PeteWasEre/Very-Kerbal-Kontroller-V2/Documentation/KSP Controller Design Data.xlsx

Sheet: Pin Map
DIO | MODE | Connection | Notes | AIO | Mode | Connection | Notes | MUX | 0 | 1 | 2 | 3 | 4 |  |  |  | Input | Output
0 | NC | NC | Mirrors USB serial | A0 | INPUT | Temp sense |  | A0 | SAS2 | FC Sensitivity |  | RCS | Throttle R |  |  | 0 | -1 | -1
1 | NC | NC | Mirrors USB serial | A1 | INPUT | Translation X |  | A1 | SAS3 | Stage |  | Lights | Throttle G |  |  | 1 | -0.9921568627 | -0.9901960784
2 | INP_PULLUP | Tr Pitch Up |  | A2 | INPUT | Translation Y |  | A2 | SAS4 | Brakes |  | Gear B | Throttle B |  |  | 2 | -0.9843137255 | -0.9803921569
3 | INP_PULLUP | Tr Pitch DN |  | A3 | INPUT | Translation Z |  | A3 | SAS5 | CLR TGT | AG 6 | Gear G | Controls R |  |  | 3 | -0.9764705882 | -0.9705882353
4 | INP_PULLUP | Tr Yaw R |  | A4 | INPUT | Rotation X |  | A4 | SAS6 | LG OFF | AG 7 | NWS | Controls G |  |  | 4 | -0.968627451 | -0.9607843137
5 | INP_PULLUP | Tr Yaw L |  | A5 | INPUT | Rotation Y |  | A5 | SAS7 | LG HI | AG 8 | Brakes G | Controls B |  |  | 5 | -0.9607843137 | -0.9509803922
6 |  |  |  | A6 | INPUT | Rotation Z |  | A6 | SAS8 | Lights | AG 9 | Brakes B | SAS R |  |  | 6 | -0.9529411765 | -0.9411764706
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
