PeteWasEre/Very-Kerbal-Kontroller-V2/Documentation/Panel Schematics.pdf

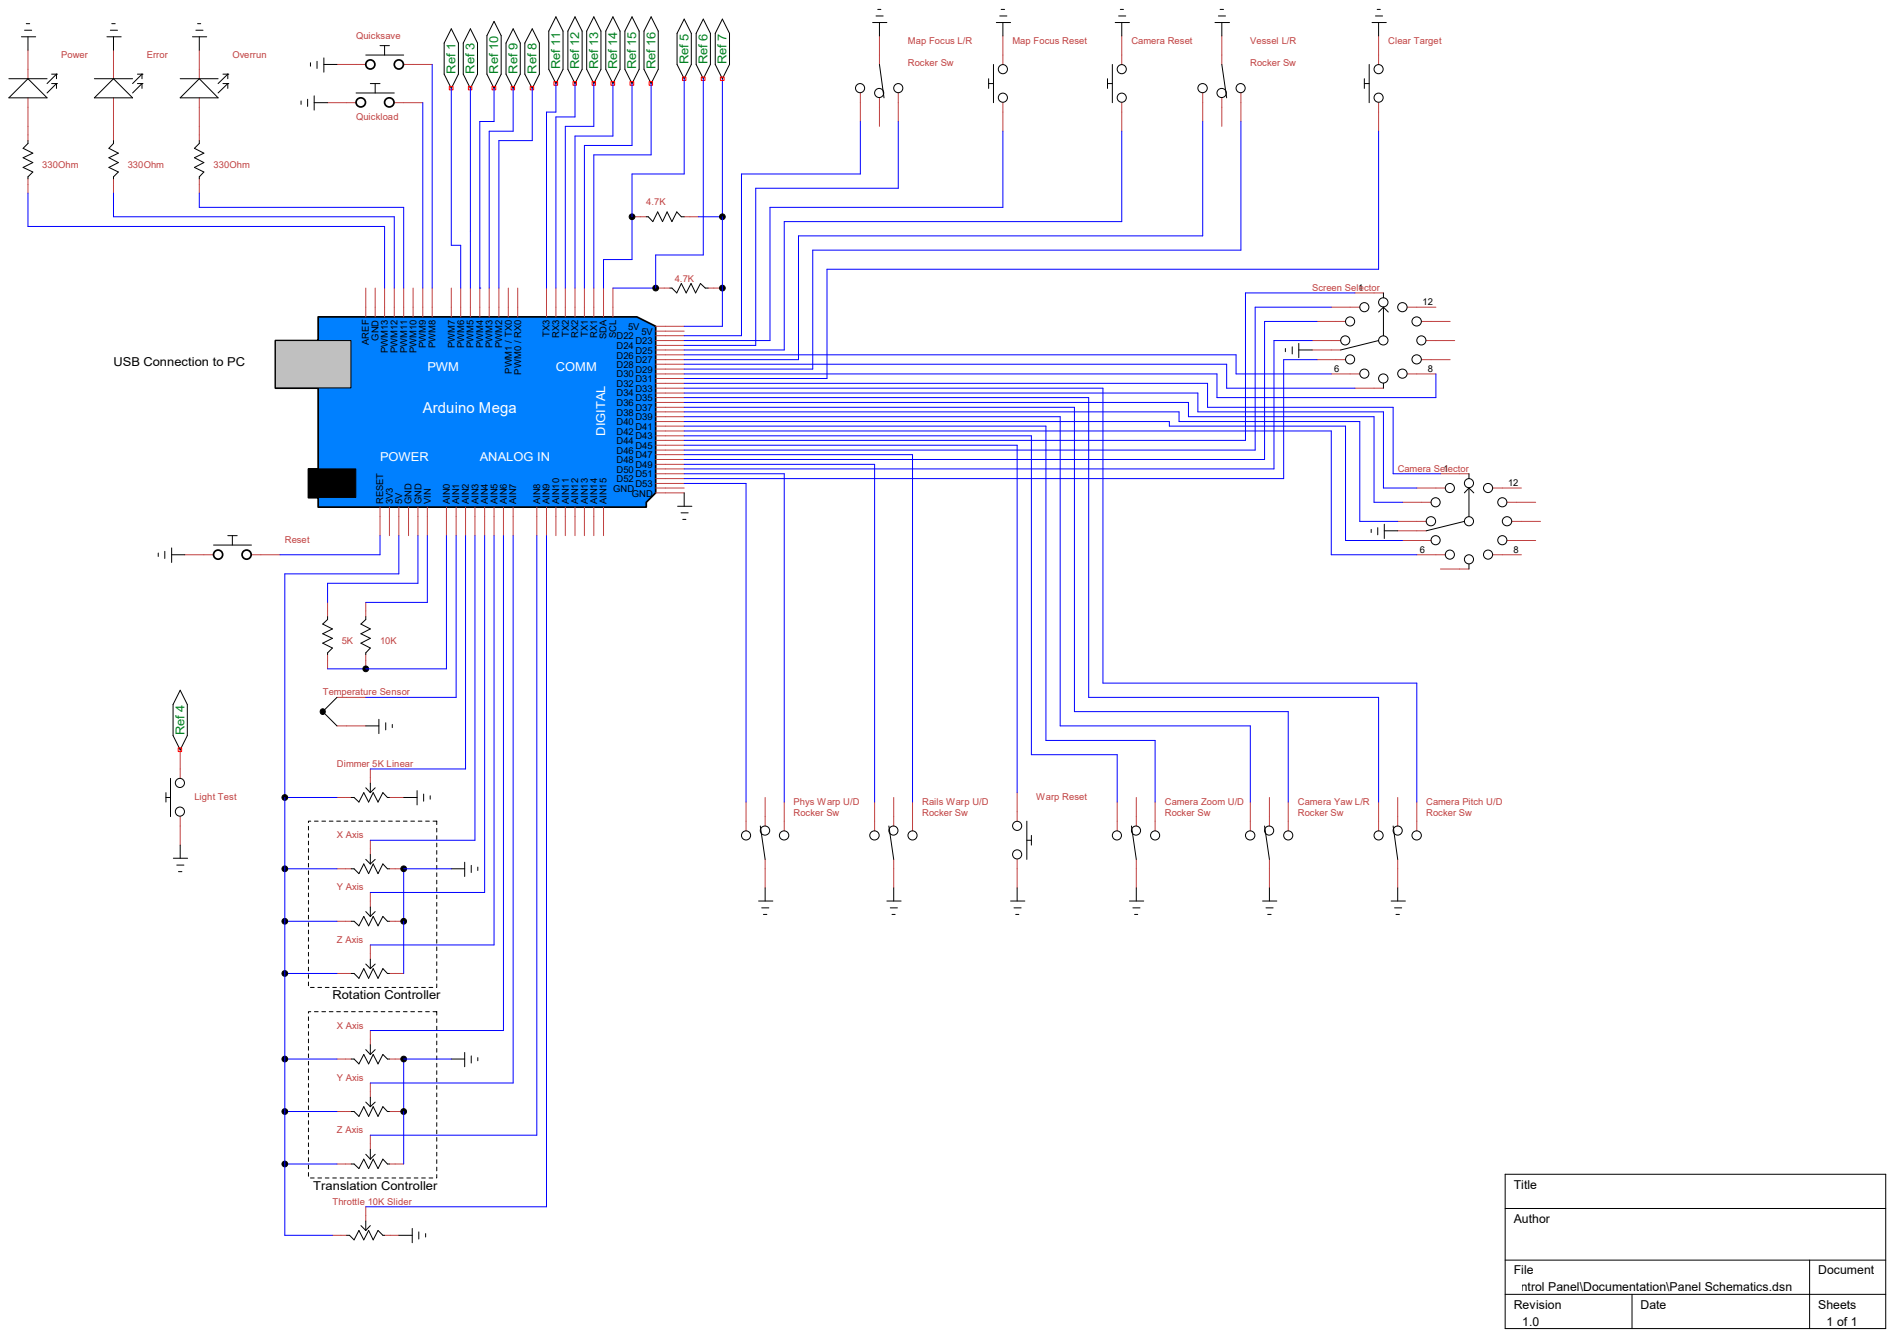
[picture p1: page 1]

USB Connection to PC

Warp Reset Rails Warp U/D
Rocker Sw

File | Document

Revision 1.0 1 of 1 | Date | Sheets

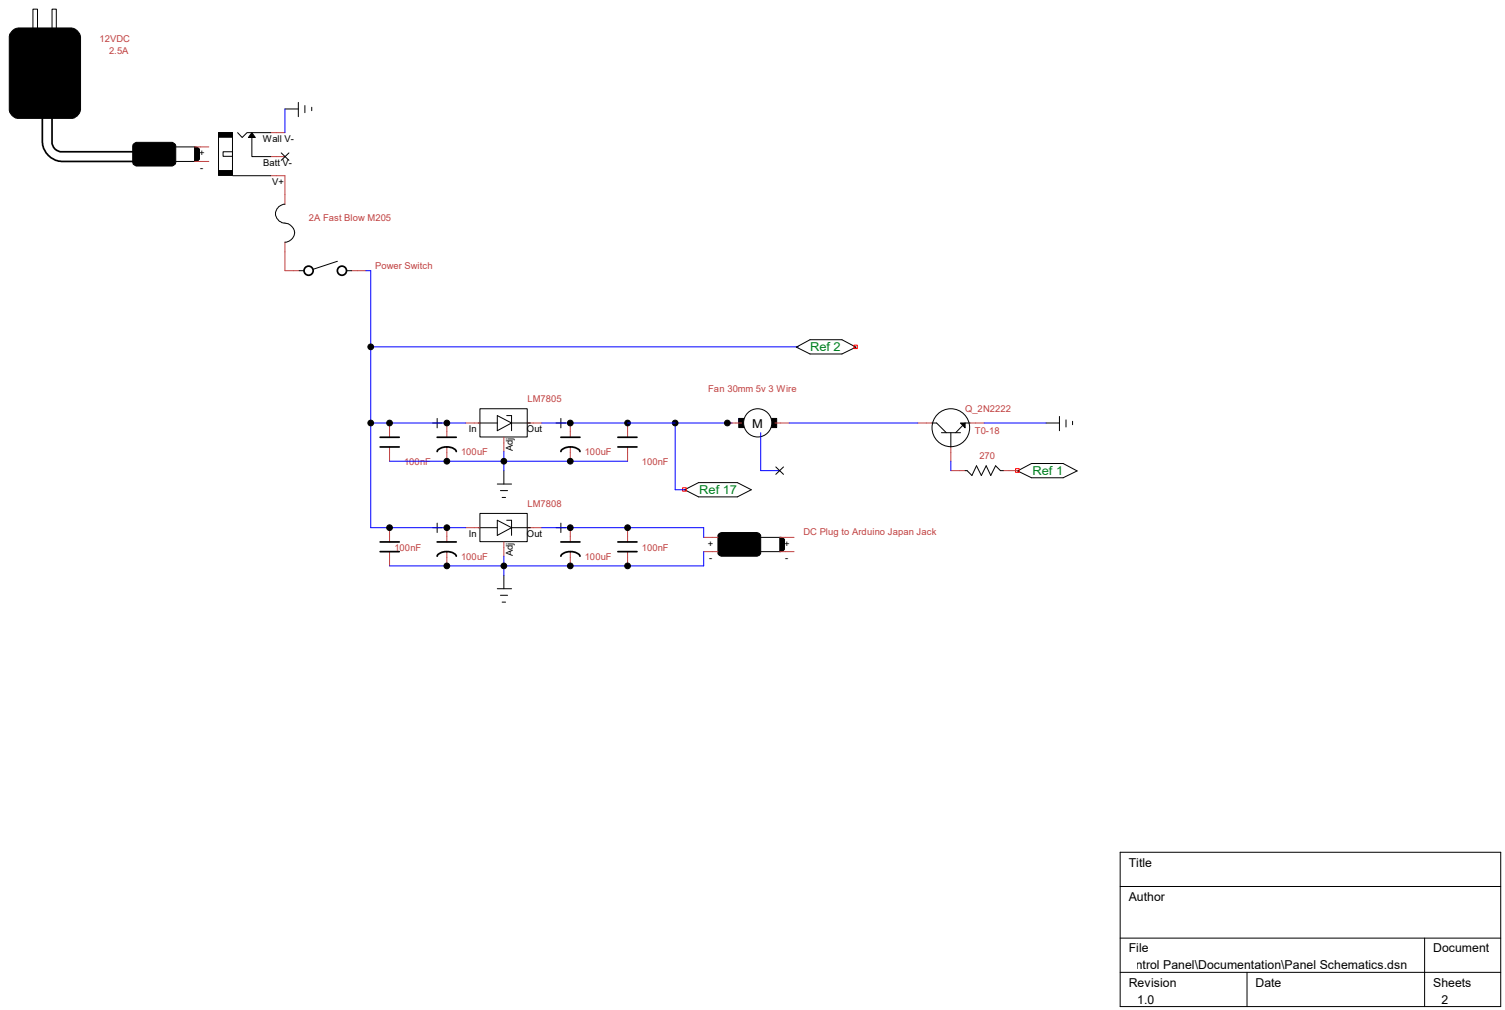
[picture p2: page 2]
12VDC 2.5A; Wall V-; Batt V-; Adj; Out; LM7805 Adj; 2A Fast Blow M205; Power Switch; Fan 30mm 5v 3 Wire; Ref 1 Ref 2; 270 Ref 17; Title

DC Plug to Arduino Japan Jack

## 270 Ref 2

## LED Strip (x9)

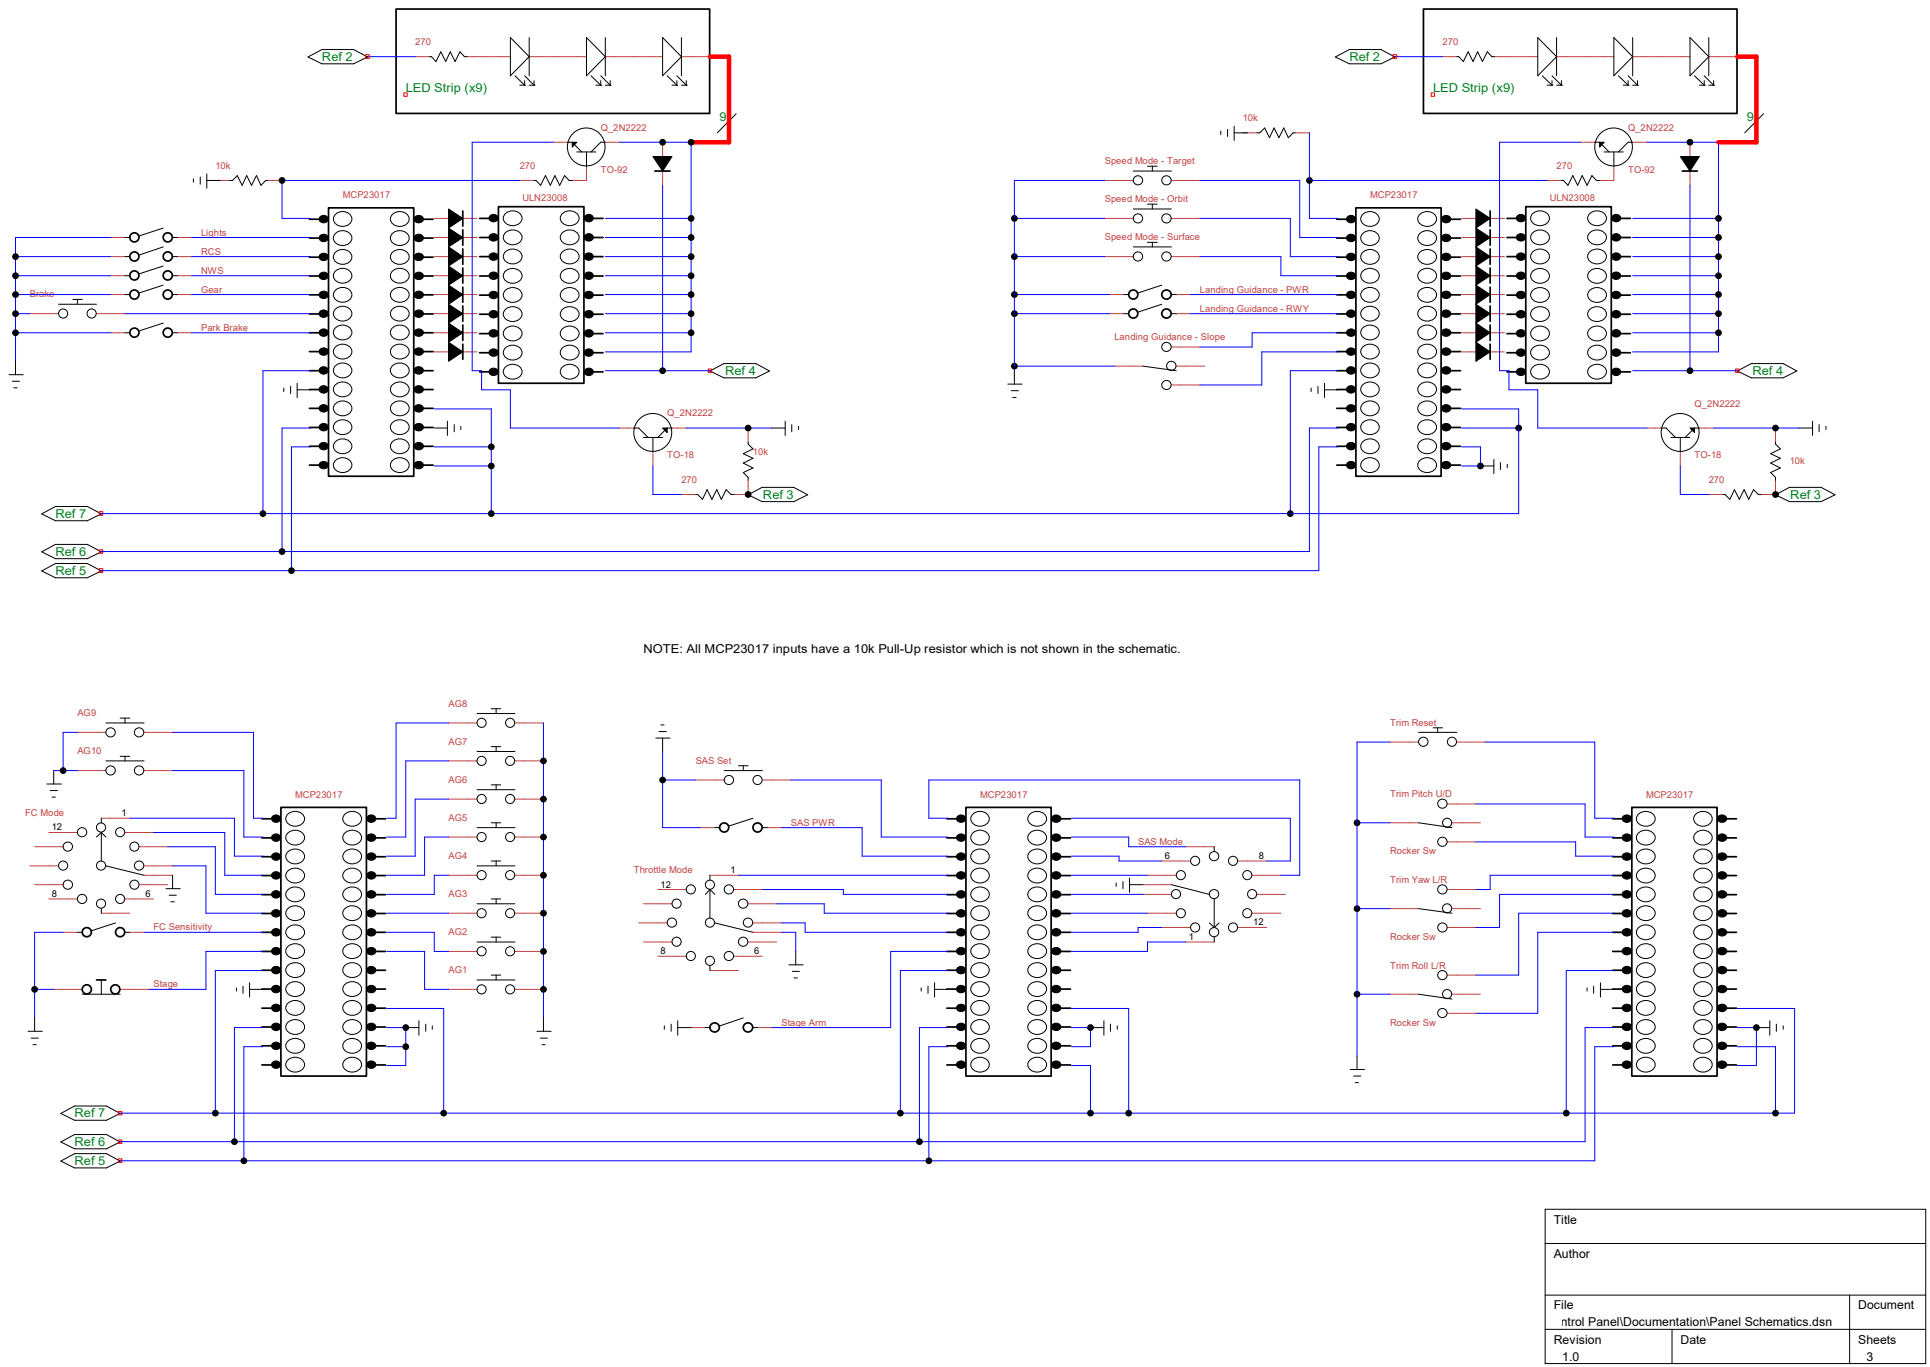
[picture p3: page 3]
MCP23017; ULN23008 Ref 5 Ref 6 Ref 7; Ref 4; Ref 3; ULN23008; 270 Ref 2; LED Strip (x9); Brake; Lights; RCS; NWS; Gear; Park Brake; Speed Mode - Target; FC Mode; FC Sensitivity; Stage; SAS Mode; Throttle Mode; Stage Arm; SAS PWR; SAS Set; Trim Reset; Trim Pitch U/D; Rocker Sw; Trim Yaw L/R; Trim Roll L/R; Title

Speed Mode - Orbit

Speed Mode - Surface

Landing Guidance - PWR
Landing Guidance - RWY

Landing Guidance - Slope

NOTE: All MCP23017 inputs have a 10k Pull-Up resistor which is not shown in the schematic.

MCP23017 Ref 5 Ref 6 Ref 7

AP6 | Ref 17 Ref 10 Ref 9 Ref 8 | Ref 12 Ref 11 Ref 13 Ref 14 Ref 15 Ref 16

## 330 QTY 3 - One set for each button group

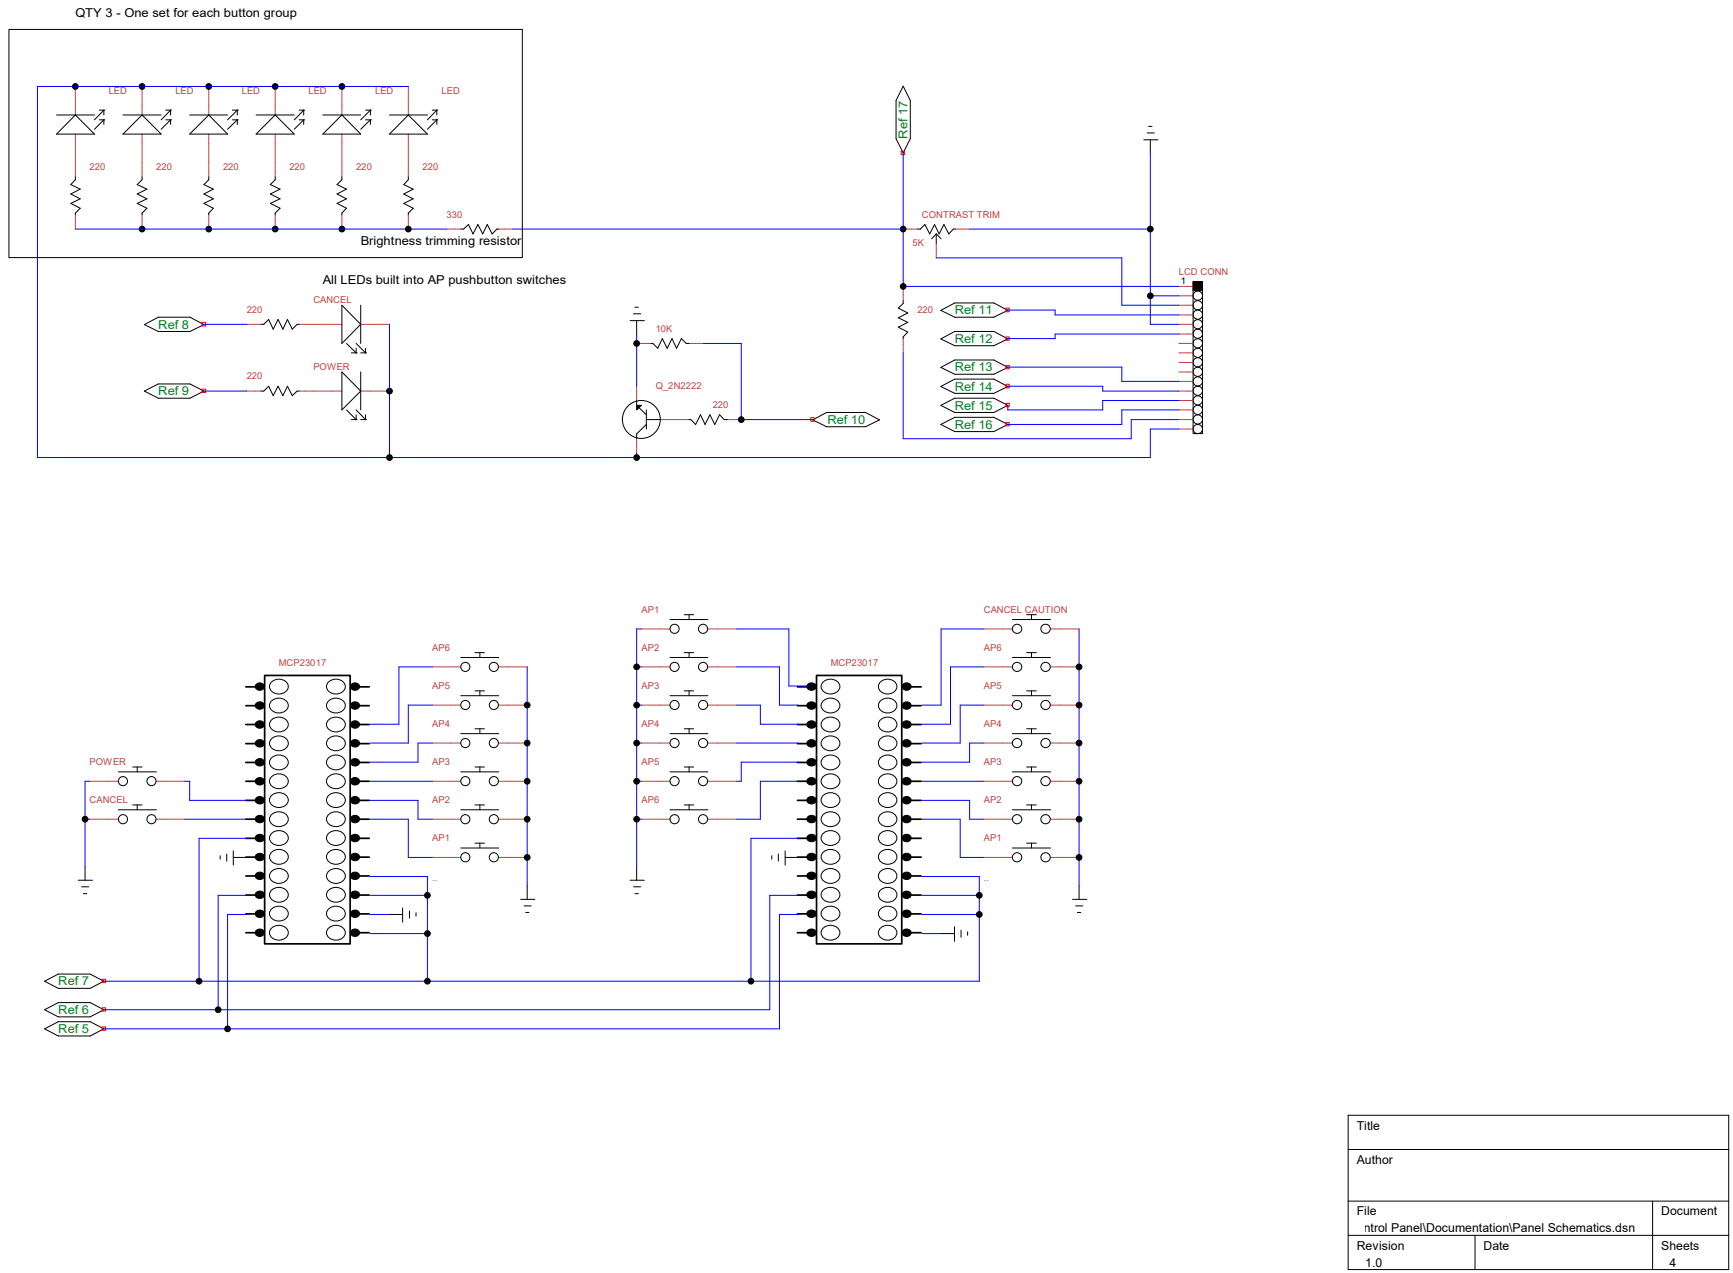
[picture p4: page 4]
POWER; CANCEL; MCP23017; CANCEL CAUTION; LCD CONN; CONTRAST TRIM; LED; Title

Brightness trimming resistor

220 All LEDs built into AP pushbutton switches

MCP23017 Ref 5 Ref 6 Ref 7
