PeteWasEre/Very-Kerbal-Kontroller-V2/(list of files, drawings)

Other design files:
Documentation/Panel Schematics.dsn
