PeteWasEre/Very-Kerbal-Kontroller-V2/Python Controller/Settings.py

# SETUP CONSTANTS
c_trim_mod_rate = 0.01
c_fctl_db = 0.1
c_fctl_fine = 0.5
c_loop_frame_rate = 0.1

c_ils_slope = 5
c_ils_slope_offset = 1
c_ils_side_offset = 50
c_ils_offset = 2390
c_ils_dist = 10000
c_ils_dist_scale = 10
c_ils_l_col = (255, 0, 0)
c_ils_m_col = (255, 255, 255)
c_ils_h_col = (255, 255, 0)

c_screen_size_x = 900
c_screen_size_y = 600
c_screen_pos = "-1800+100"

c_input_buffer_size = 19

c_vessel_sw_dist = 2300

c_sas_reset_delay = 0.005

msg_prefix = ('MSG', 'ERROR', 'CRITICAL ERROR')
