PeteWasEre/Very-Kerbal-Kontroller-V2/(commit log)

2018-05-01 V2 Baseline
    Modified baseline to suit V2 Panel
    [KSP Controller Design Data.xlsx]
2018-10-01 fixing disconnects
    Fixing the disconnects on vessel switch and scene change. still issues with EVA. also a few code PEP cleanups
    [GUI.py, PanelControl.py]
